rdevaul/yapPhoneBot/reference/Phonebot_BOM.xlsx

PhoneBot Bill of Materials
Item ID | Category | Subassembly | Part / Description | Qty | Unit | Material / Specification | Manufacturer / Supplier | Part Number | Unit Cost | Total Cost | Source / URL | Notes
3DP_1 | 3D Printed Part | Lower Body | PelvisTop | 1 | Each | PLA |  |  | $18.99 | $18.99 | PLA Basic | Bambu Lab US Store | The cost is based on one roll of PLA material from Bambu Lab
3DP_2 | 3D Printed Part | Lower Body | PelvisBottom | 1 | Each | PLA
3DP_3 | 3D Printed Part | Lower Body | HipBracket | 2 | Each | PLA
3DP_4 | 3D Printed Part | Lower Body | UpperLegLink | 2 | Each | PLA
3DP_5 | 3D Printed Part | Lower Body | LowerLegLink | 2 | Each | PLA
3DP_6 | 3D Printed Part | Lower Body | MotorConnection | 4 | Each | PLA
3DP_7 | 3D Printed Part | Lower Body | IdlerServoBracket | 2 | Each | PLA
3DP_8 | 3D Printed Part | Lower Body | Foot | 2 | Each | PLA
3DP_9 | 3D Printed Part | Torso | TorsoBase | 1 | Each | PLA
3DP_10 | 3D Printed Part | Torso | ElectronicsFrame | 1 | Each | PLA
3DP_11 | 3D Printed Part | Torso | PhoneMount | 1 | Each | PLA
F_1 | Standard Fastener |  | M2*5 Pan Head Screw | 92 | Each |  | Amazon | B0H5K71XJ3 | $0.12 | $11.02 | M2 x 5mm (50 Pack) Pan Head Machine Screw, Phillips Drive, Black Oxide 304 Stainless Steel, Fully Threaded,for Furniture Repairs and 3D Printer: Amazon.com: Industrial & Scientific (https://www.amazon.com/Machine-Phillips-Stainless-Threaded-Furniture/dp/B0H5K71XJ3) | Screws from motor boxes are enough for assembly
F_2 | Standard Fastener |  | M2.5*5 Thread Forming Screw | 32 | Each |  | Amazon | B0GY7QTS6R | $0.03 | $1.04 | IMSCREWS 400 Pcs M2.6 x 5mm Black Self Tapping Screws, 304 Stainless Steel Phillips Pan Washer Head, Natural Black No Peeling, Type A Point for Metal/Wood/Plastic: Amazon.com: Industrial & Scientific (https://www.amazon.com/IMSCREWS-Tapping-Stainless-Phillips-Natural/dp/B0GY7QTS6R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) | Screws from motor boxes are enough for assembly
F_3 | Standard Fastener |  | M2.5*12 Flat Head Screw | 60 | Each |  | Amazon | B0CG1QB1PD | $0.07 | $4.19 | M2.5-0.45 x 12mm Flat Head Socket Cap Screws, 10.9 Grade Alloy Steel,DIN 7991,Allen Socket Drive, Black Oxide Finish, Machine Thread, Countersunk Bolts,Fully Thread Quantity 100: Amazon.com: Industrial & Scientific (https://www.amazon.com/M2-5-0-45-Socket-Machine-Countersunk-Quantity/dp/B0CG1QB1PD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)
F_4 | Standard Fastener |  | M2.5*4 Round Head Screw | 6 | Each |  | Amazon | B0H5K1S5BR | $0.12 | $0.72 | M2.5 x 4mm(50 Pack) Button Head Hex Socket Cap Screws Bolts, Hex Drive Bright Finish Fully Machine Thread, Corrosion Resistant Black Oxide 304 Stainless Steel 18-8 Screws: Amazon.com: Industrial & Scientific (https://www.amazon.com/Button-Machine-Corrosion-Resistant-Stainless/dp/B0H5K1S5BR?s=industrial)
F_5 | Standard Fastener |  | M3*6 Round Head Screw | 9 | Each |  | Amazon | B0GJJGGS6R | $0.12 | $1.08 | M3 x 6mm(50 Pack) Button Head Hex Socket Cap Screws Bolts, Hex Drive Bright Finish Fully Machine Thread, Corrosion Resistant Black Oxide 304 Stainless Steel 18-8 Screws: Amazon.com: Industrial & Scientific (https://www.amazon.com/Button-Machine-Corrosion-Resistant-Stainless/dp/B0GJJGGS6R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)
F_6 | Standard Fastener |  | M3*10 Standoff | 4 | Each |  | Amazon | B07BLSRZYJ | $0.19 | $0.75 | PATIKIL 50 Pcs Male to Female Thread Spacer Screws M3 x 16mm + 6mm Brass Hex Standoff PCB Motherboard Spacer Screw Nut for Drone Quadcopter Computer Electronic Projects Circuit Board: Amazon.com: Industrial & Scientific (https://www.amazon.com/PATIKIL-Standoff-Motherboard-Quadcopter-Electronic/dp/B0FB2KP89V?s=industrial)
F_7 | Standard Fastener |  | M3*16 Standoff | 4 | Each |  | Amazon | B0FB2RPB24 | $0.25 | $0.99 | PATIKIL 50 Pcs Male to Female Thread Spacer Screws M3 x 16mm + 6mm Brass Hex Standoff PCB Motherboard Spacer Screw Nut for Drone Quadcopter Computer Electronic Projects Circuit Board: Amazon.com: Industrial & Scientific (https://www.amazon.com/PATIKIL-Standoff-Motherboard-Quadcopter-Electronic/dp/B0FB2RPB24?s=industrial)
F_8 | Standard Fastener |  | M2.5 Heat Insert | 6 | Each |  | McMaster | 94180A321 | $0.18 | $1.05 | Brass Tapered Heat-Set Threaded Inserts, for Plastic, M2.5 x 0.45mm Thread, 3.4mm Installed Length | McMaster-Carr (https://www.mcmaster.com/94180A321/)
F_9 | Standard Fastener |  | M3 Heat Insert | 9 | Each |  | McMaster | 94180A331 | $0.20 | $1.84 | Brass Tapered Heat-Set Threaded Inserts, for Plastic, M3 x 0.5mm Thread Size, 3.8mm Installed Length | McMaster-Carr (https://www.mcmaster.com/94180A331/)
F_10 | Standard Fastener |  | Thurst Needle Roller Bearing with Washers | 1 | Each |  | Amazon | B0GXNCS1ZD | $1.69 | $1.69 | uxcell 8 Sets AXK2542 Thrust Needle Roller Bearings with Washers, ID 25mm | OD 42mm, Thickness 4mm Chrome Steel, Needle Roller Bearings: Amazon.com: Industrial & Scientific (https://www.amazon.com/uxcell-AXK2542-Thrust-Bearings-Washers/dp/B0GXNCS1ZD?sp_csd=d2lkZ2V0TmFtZT1zcF9hdGY)
E_1 | Electronics |  | XL430-W250-T | 13 | Each |  | Robotis | 902-0135-000 | $23.90 | $310.70 | XL430-W250-T > XL Series | ROBOTIS (https://en.robotis.com/shop_en/item.php?it_id=902-0135-000)
E_2 | Electronics |  | U2D2 Power Hub | 1 | Each |  | Robotis | 902-0145-001 | $19.00 | $19.00 | U2D2 PHB Set > Interface | ROBOTIS (https://en.robotis.com/shop_en/item.php?it_id=902-0145-001)
E_3 | Electronics |  | U2D2 | 1 | Each |  | Robotis | 902-0132-000 | $32.10 | $32.10 | U2D2_INT > Interface | ROBOTIS (https://en.robotis.com/shop_en/item.php?it_id=902-0132-000)
E_4 | Electronics |  | Radxa ZERO 3W | 1 | Each |  | ARACE | RS107-D2E0H1W15 | $19.00 | $19.00 | Radxa Zero 3w Single Board Computer With Rk3566 4-core Cpu Gpu Npu 1080p Output Wifi 6 Bt 5.4 Enhanced Connectivity - Buy Product on Alibaba.com (https://www.alibaba.com/product-detail/Radxa-ZERO-3W-Single-Board-Computer_1601435694506.html)
E_5 | Electronics |  | LM2596 DC Converter | 1 | Each |  | Amazon | B0DBVYP91F | $1.60 | $1.60 | Amazon.com: Seloky 5 Pack LM2596 DC to DC Buck Converter 3.0-40V to 1.5-35V Adjustable Voltage Regulator Electronic Voltage Stabilizer Power Supply Step Down Module : Electronics (https://www.amazon.com/Seloky-Converter-Adjustable-Electronic-Stabilizer/dp/B0DBVYP91F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)
E_6 | Electronics |  | 3S Lipo Battery 2200mAh | 1 | Each |  | Amazon | B0BYNSH6Q7 | $17.06 | $17.06 | Amazon.com: Zeee 3S Lipo Battery 2200mAh 11.1V 50C Shorty Pack Battery with XT60 Plug for RC Car Truck RC Vehicles Boat Drone RC Airplane Quadcopter Helicopter FPV Racing Hobby Models(2 Pack) : Toys & Games (https://www.amazon.com/Zeee-Vehicles-Airplane-Quadcopter-Helicopter/dp/B0BYNSH6Q7)
