rdevaul/yapPhoneBot/reference/PhoneBot_Asm.step

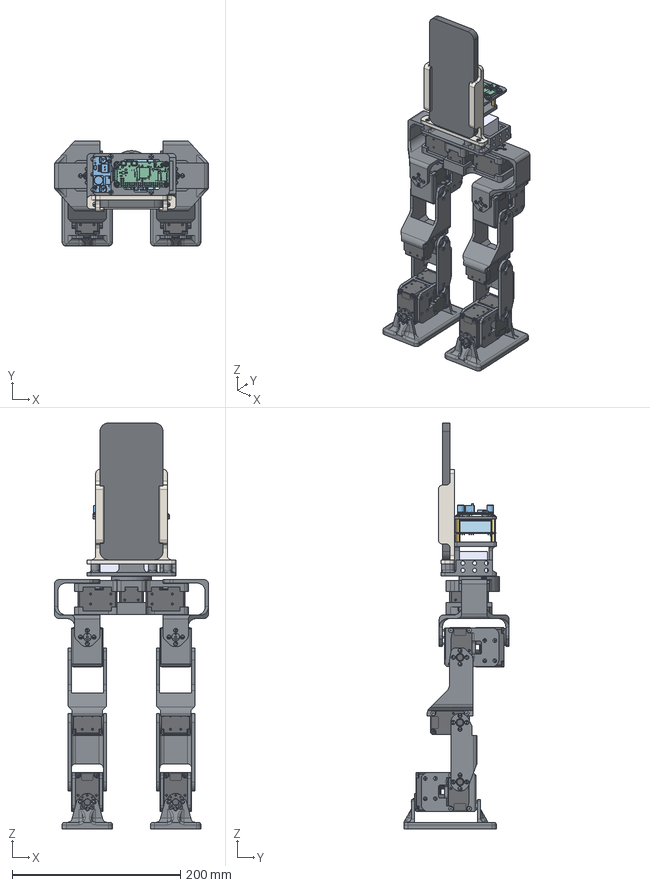
[picture p1: CAD file, 2026-10-24]
reference/PhoneBot_Asm.step
183.0 x 125.2 x 482.4 mm
92000A012 M2x5 PanHead x 92
M2.5x12-FlatHead x 60
M2x6-SocketHead x 4
Foot x 2
5909K76-Washer x 2
LowerLegLink x 2
PelvisTop
UpperLegLink x 2
HipBracket x 2
PelvisBottom
98952A108-M3x10-HexStandoff x 4
94180A331-M3-HeatInsert x 9
PhoneMount
Part2_ADA3708__NONE x 80
ram__NONE x 171
545482271__NONE x 26
690 - 019 - 298 - 903__NONE x 21
690 - 005 - 298 - 486__NONE_1 x 69
690 - 005 - 298 - 486__NONE x 69
pcb__NONE x 49
1040310811__NONE x 9
BCM 2835__NONE x 2
ROBOTIS_U2D2-1/U2D2.ASM-1/PCB_U2D2.PRT-1-solid1
ROBOTIS_U2D2_Power_Hub_Board-1/JST-B4B-EH-A.PRT.1-3-solid1
ROBOTIS_U2D2-1/U2D2.ASM-1/MICRO_USB_2_0_CONNECTOR__AB_REC.PRT-1-solid 1
ROBOTIS_U2D2_Power_Hub_Board-1/JST-B3B-EH-A.PRT.1-2-solid1
ROBOTIS_U2D2-1/U2D2.ASM-1/JST-B4B-PH-K-S.PRT-1-solid1
ROBOTIS_U2D2-1/U2D2.ASM-1/U2D2_CASING.PRT-1-solid1
ROBOTIS_U2D2_Power_Hub_Board-1/JST-B3B-EH-A.PRT.1-1-solid1
ROBOTIS_U2D2-1/U2D2.ASM-1/JST-B4B-EH-A.PRT-1-solid1
ROBOTIS_U2D2_Power_Hub_Board-1/JST-B4B-EH-A.PRT.1-2-solid1
ROBOTIS_U2D2-1/U2D2.ASM-1/JST-B3B-EH-A.PRT-1-solid1
ROBOTIS_U2D2_Power_Hub_Board-1/JST-B4B-EH-A.PRT.1-1-solid1
ROBOTIS_U2D2_Power_Hub_Board-1/JST-B3B-EH-A.PRT.1-3-solid1
ROBOTIS_U2D2_Power_Hub_Board-1/39281023.stp-1/39281023.prt-1-solid1
ROBOTIS_U2D2_Power_Hub_Board-1/Board-1-solid1
92095A456-M2.5x4-ButtonHead x 6
M2.5-HeatInsert x 6
M3x6-ButtonHead x 9
98952A114-M3x16-HexStandoff x 4
Phone
User Library-DC-DC MODULE LM2596s_User Library-TO-263-5_TO-263-5_Body _1__NONE
User Library-DC-DC MODULE LM2596s_User Library-TO-263-5_TO-263-5_Lead s_1__NONE
User Library-DC-DC MODULE LM2596s_User Library-TO-263-5_TO-263-5_Mark ing_1__NONE x 8
PCB_LM2596 corrected 061823__NONE
DIODE_LM2596__NONE
User Library-DC-DC MODULE LM2596s_C0603__NONE_1
POT_LM2596__NONE
User Library-DC-DC MODULE LM2596s_C0603__NONE
User Library-DC-DC MODULE LM2596s_User Library-ALU-F_Pins_1__NONE_1
User Library-DC-DC MODULE LM2596s_R0603__NONE
INDUCTOR_LM2596__NONE
User Library-DC-DC MODULE LM2596s_User Library-ALU-F_Fuss_1__NONE_1
User Library-DC-DC MODULE LM2596s_User Library-ALU-F_Fuss_1__NONE
User Library-DC-DC MODULE LM2596s_User Library-ALU-F_K_X_F6rper_1__NO NE_1
User Library-DC-DC MODULE LM2596s_User Library-ALU-F_K_X_F6rper_1__NO NE
User Library-DC-DC MODULE LM2596s_User Library-ALU-F_Beschriftung_1__ NONE_1
User Library-DC-DC MODULE LM2596s_User Library-ALU-F_Beschriftung_1__ NONE
User Library-DC-DC MODULE LM2596s_User Library-ALU-F_Pins_1__NONE
ElectronicsFrame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
