rdevaul/yapPhoneBot/reference/stl/thigh_link.stl

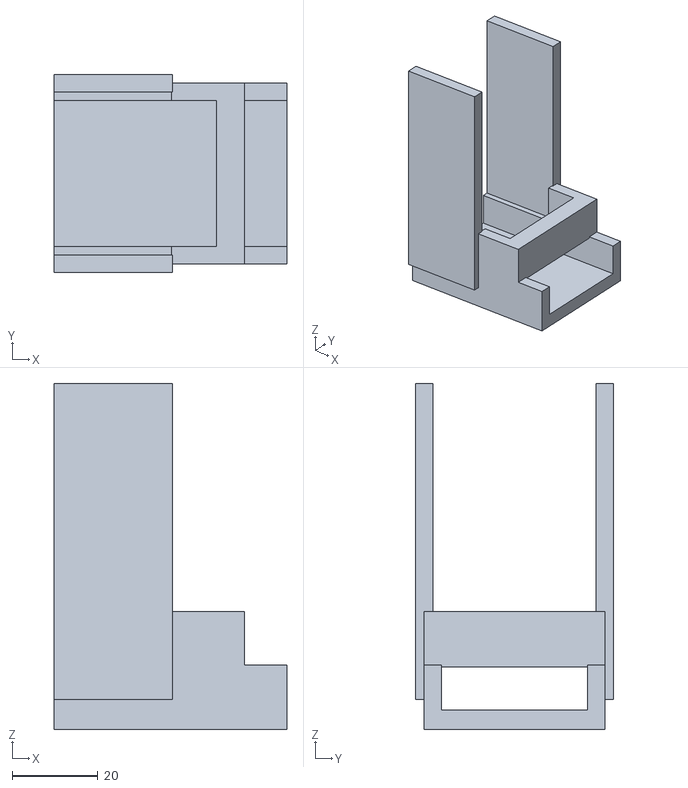
[picture p2: CAD file, 2026-10-24]
reference/stl/thigh_link.stl
54.2 x 46.0 x 80.5
