rdevaul/yapPhoneBot/reference/stl/IdlerServoBracket.stl

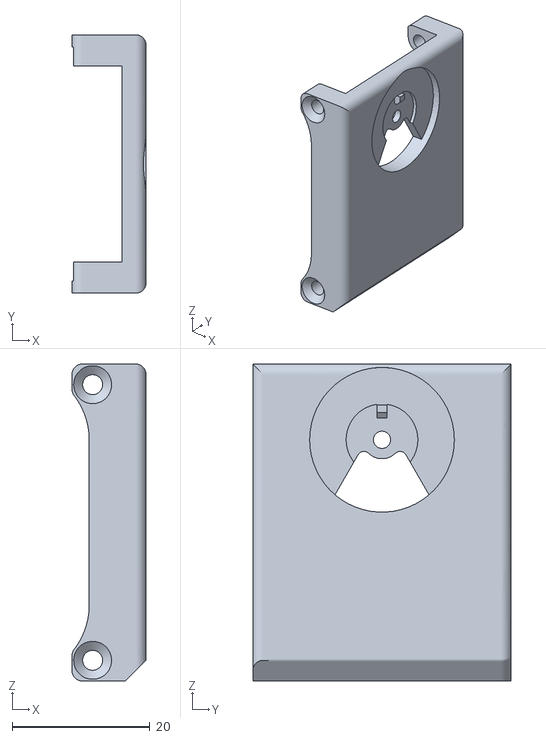
[picture p3: CAD file, 2026-10-24]
reference/stl/IdlerServoBracket.stl
10.7 x 37.5 x 46.0
