rdevaul/yapPhoneBot/reference/stl/ElectronicsFrame.stl

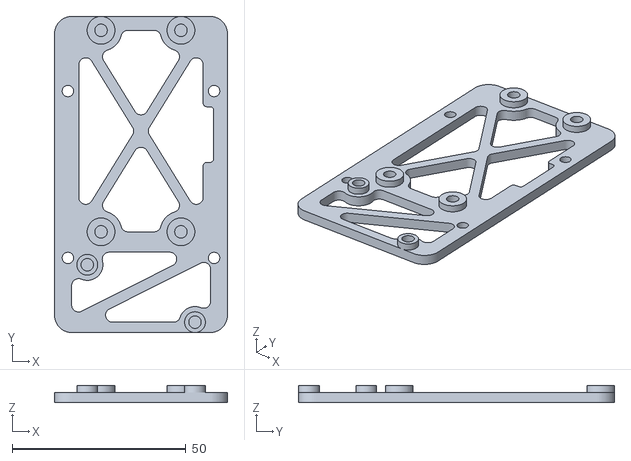
[picture p4: CAD file, 2026-10-24]
reference/stl/ElectronicsFrame.stl
49.8 x 91.0 x 5.00
