rdevaul/yapPhoneBot/reference/stl/foot_plate.stl

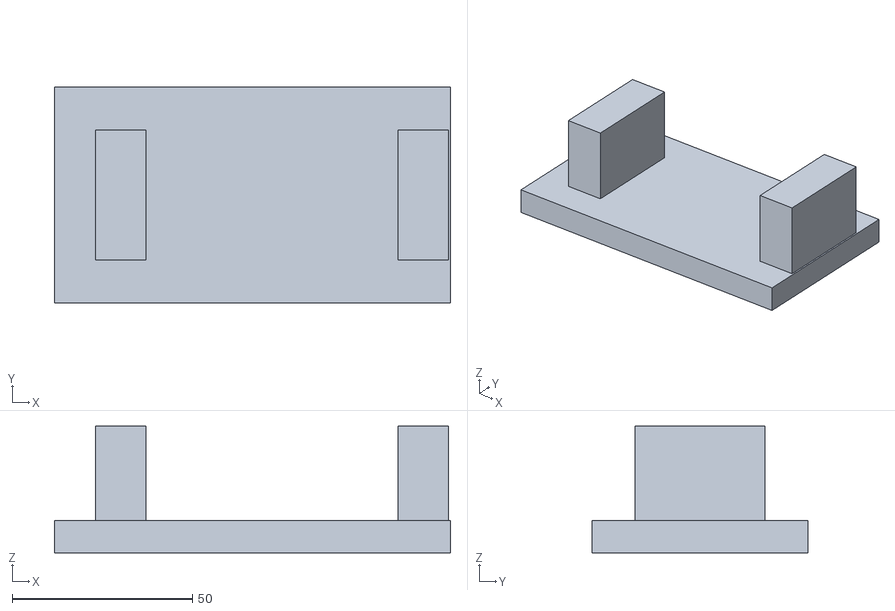
[picture p5: CAD file, 2026-10-24]
reference/stl/foot_plate.stl
110.0 x 60.0 x 35.2
