rdevaul/yapPhoneBot/reference/stl/shin_link.stl

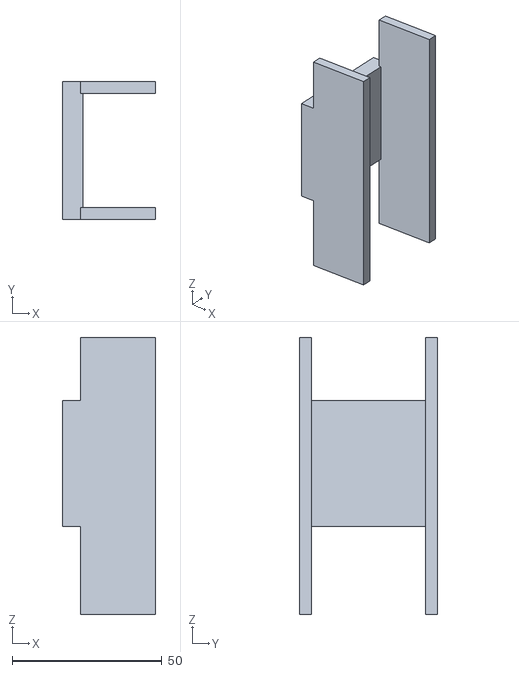
[picture p6: CAD file, 2026-10-24]
reference/stl/shin_link.stl
31.0 x 46.0 x 92.4
