rdevaul/yapPhoneBot/reference/stl/LowerLegLink.stl

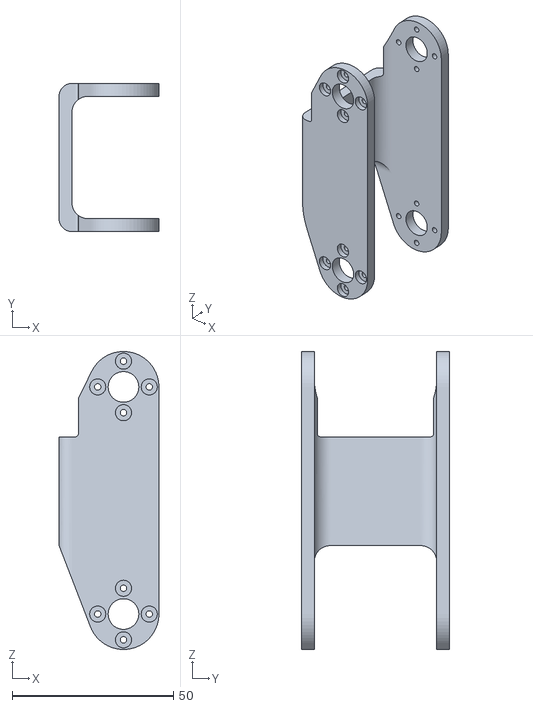
[picture p7: CAD file, 2026-10-24]
reference/stl/LowerLegLink.stl
31.0 x 46.0 x 92.5
