rdevaul/yapPhoneBot/reference/stl/MotorConnection.stl

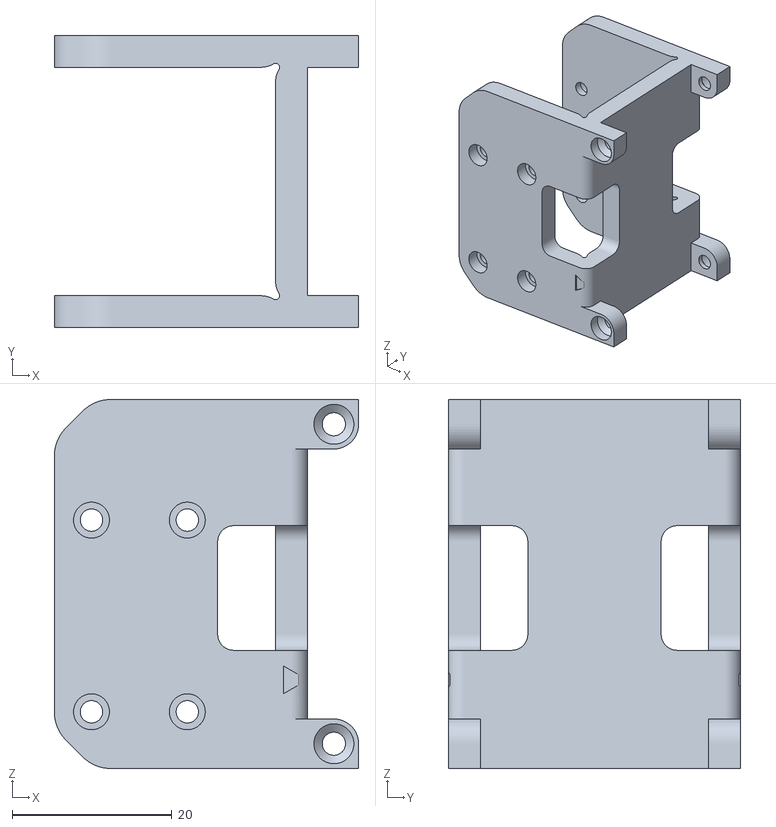
[picture p8: CAD file, 2026-10-24]
reference/stl/MotorConnection.stl
38.1 x 36.6 x 46.2
