rdevaul/yapPhoneBot/reference/stl/UpperLegLink.stl

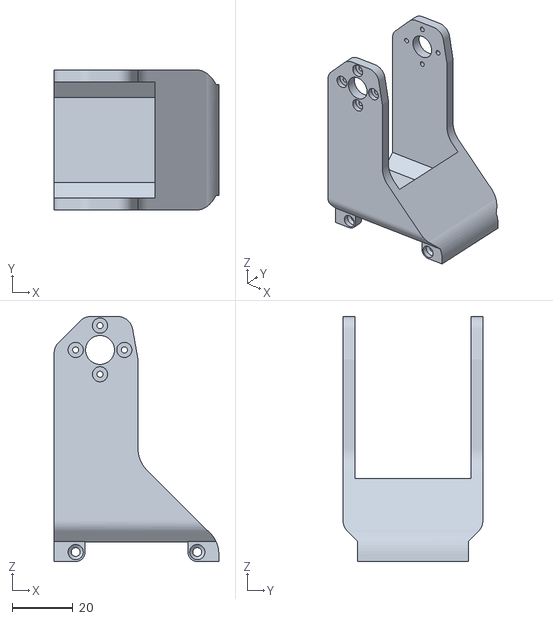
[picture p9: CAD file, 2026-10-24]
reference/stl/UpperLegLink.stl
54.2 x 46.0 x 80.6
