rdevaul/yapPhoneBot/reference/stl/PelvisBottom.stl

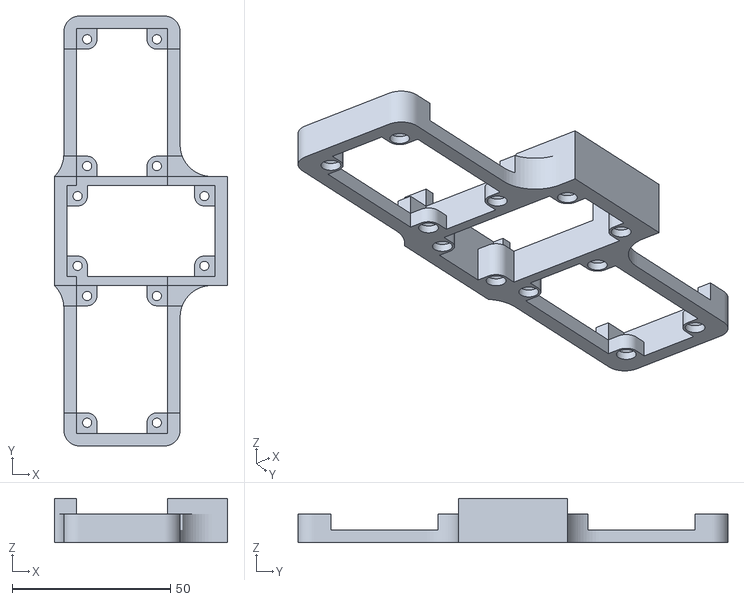
[picture p10: CAD file, 2026-10-24]
reference/stl/PelvisBottom.stl
54.7 x 135.7 x 14.0
