rdevaul/yapPhoneBot/reference/stl/Foot.stl

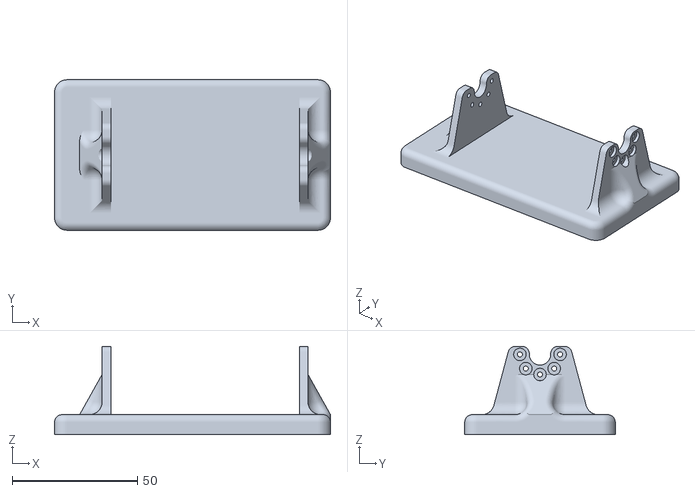
[picture p11: CAD file, 2026-10-24]
reference/stl/Foot.stl
110.0 x 60.0 x 35.2
