rdevaul/yapPhoneBot/reference/stl/PelvisTop.stl

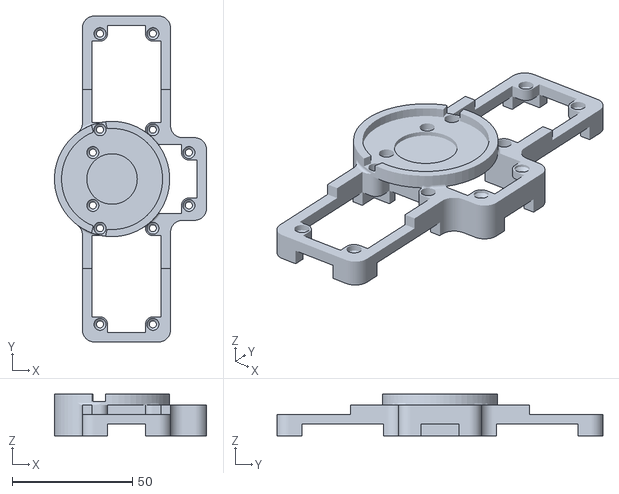
[picture p12: CAD file, 2026-10-24]
reference/stl/PelvisTop.stl
63.3 x 135.7 x 17.4
