rdevaul/yapPhoneBot/reference/stl/HipBracket.stl

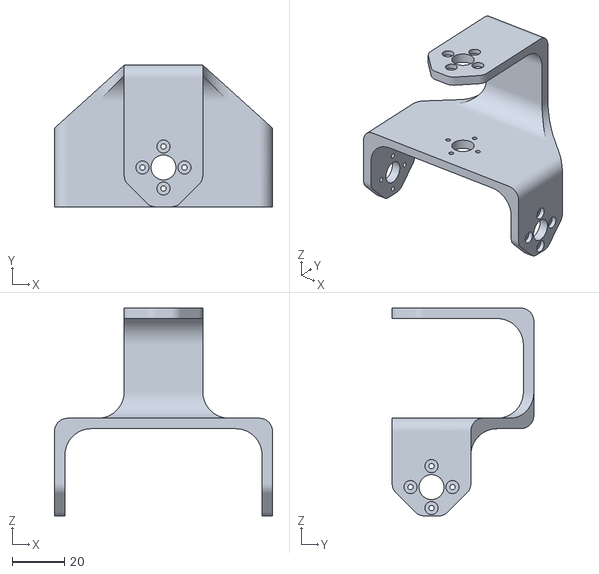
[picture p13: CAD file, 2026-10-24]
reference/stl/HipBracket.stl
83.1 x 54.0 x 79.3
