rdevaul/yapPhoneBot/reference/stl/TorsoBase.stl

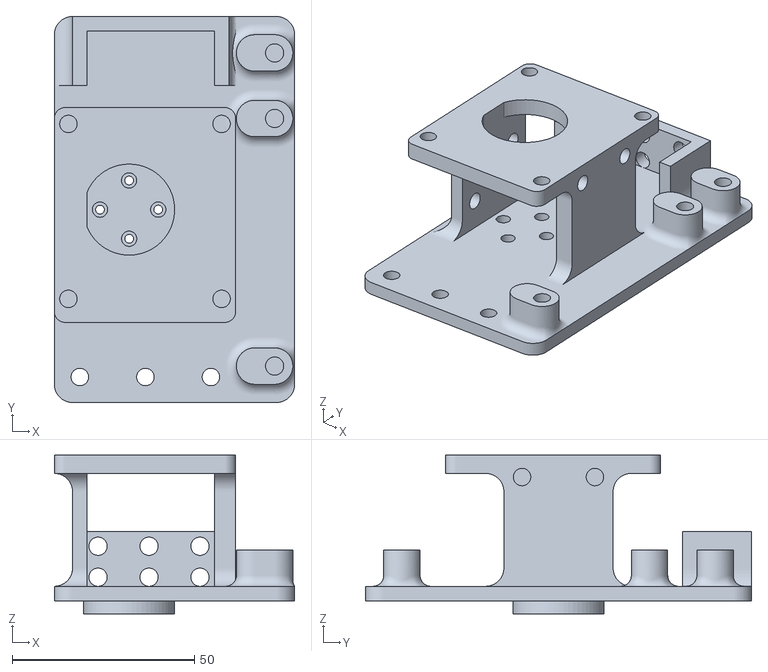
[picture p14: CAD file, 2026-10-24]
reference/stl/TorsoBase.stl
66.0 x 106.0 x 43.5
