rdevaul/yapPhoneBot/reference/stl/Phone.stl

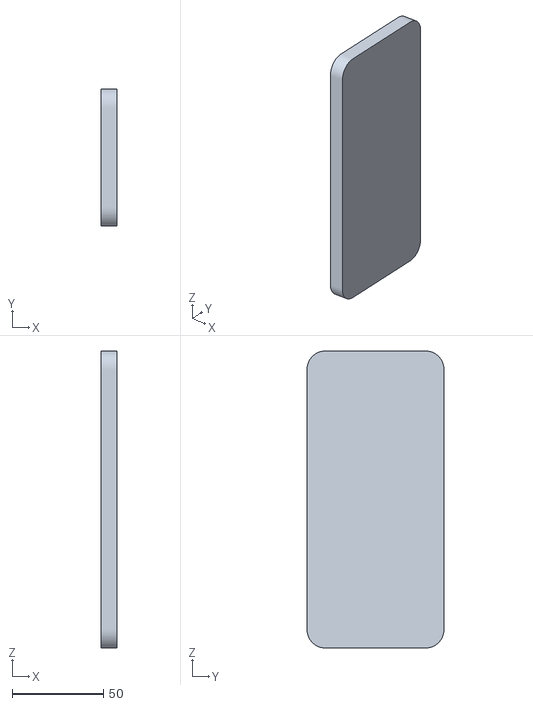
[picture p15: CAD file, 2026-10-24]
reference/stl/Phone.stl
9.00 x 74.9 x 162.6
