rdevaul/yapPhoneBot/reference/stl/PhoneMount.stl

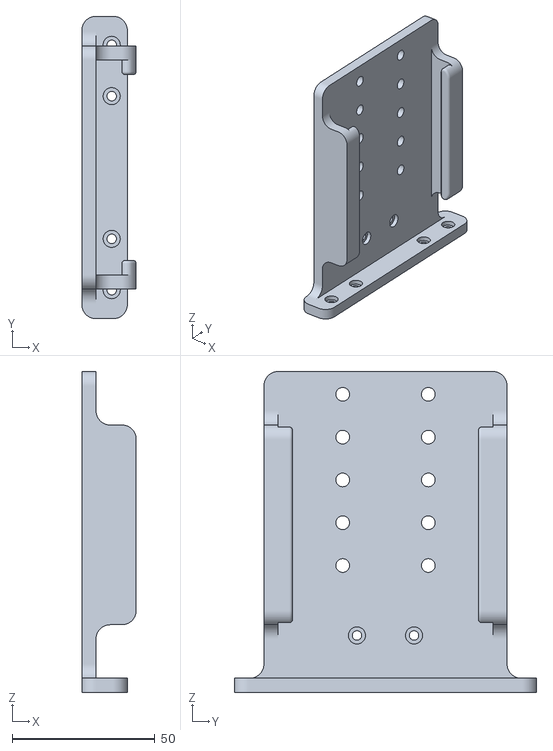
[picture p16: CAD file, 2026-10-24]
reference/stl/PhoneMount.stl
19.1 x 106.0 x 112.5
