rdevaul/yapPhoneBot/(list of files, cad)

Other CAD files:
reference/stl/local_LowerLegLink.stl
reference/stl/local_UpperLegLink.stl
reference/stl/local_Foot.stl
