rdevaul/yapPhoneBot/(commit log)

2026-10-24 Initial commit: yapPhoneBot v0.1.0 scaffolding
    - designs/: yaphonebot_servo.dsl, yaphonebot_leg.dsl, yaphonebot_torso.dsl, yaphonebot_assembly.dsl
    - src/yaphonebot/kinematics/: forward kinematics chain (DH parameters)
    - tests/: geometry comparison tests + kinematics validation
    - bom/: procurement catalog v0.1
    - tools/build_ycpkg.py: package builder (stub)
    - MIT licensed, inspired by phonebot.dev (CC BY-NC 4.0)
2026-10-24 Switch to SDF-first build (yapCAD 1.2.0+)
    - Updated yapCAD pin to latest main (e530149) with SDF geometry system
    - environment.yml: OCC now optional, SDF works with numpy-only conda env
    - build_ycpkg.py: uses representation='sdf' with per-part fallback
    - README: notes that OCC is optional for development
2026-10-24 DSL files working — STL generation proven
    - Fixed all 4 .dsl files to match yapCAD v2 DSL syntax:
    - No 'let' keyword (deprecated) — use 'name: type = value'
    - No 'param' keyword — use command-based constants
    - No module-level vars — all declarations inside commands
    - 'shell' is a reserved type keyword, renamed to 'hull'
    - assembly builtins: assembly() / add_part() / compound()
    - Generated STL outputs from yapCAD run:
    - xl430_envelope.stl (46k vol, 85KB STL)
    - left_leg.stl (389k vol, 181KB STL)
    - torso.stl (451k vol, 117KB STL)
    - phonebot_full.stl (1.23M vol, 478KB STL — full robot)
    - Remaining: individual leg/torso/servo .dsl files are subs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
2026-10-24 Re-architect to multi-file DSL modules with 'use' imports
    DSL files now use proper cross-file imports:
    - yaphonebot_servo.dsl: XL430-W250-T envelope (base primitive)
    - yaphonebot_leg.dsl: 6-DoF leg chain (use yaphonebot_servo)
    - yaphonebot_torso.dsl: torso yaw joint + accessories (use yaphonebot_servo)
    - yaphonebot_assembly.dsl: full robot (use yaphonebot_leg, use yaphonebot_torso)
    The yapCAD DSL 'use' statement was previously unimplemented (parsed
    but never resolved). The fix is in PR#100 on rdevaul/yapCAD
    (fix/dsl-use-imports branch). This repo works with the patched version.
2026-10-24 Align geometry with reference CAD: fix servo envelope, part shapes, coordinate frame, and joint centers
    - **servo.dsl**: Reorient body axis (X=46.5, Y=28.5, Z=34.0) and shaft
    diameter/offset to match GrabCAD / Robotis datasheet
    - **torso.dsl**: Complete rewrite — PelvisTop/Bottom, TorsoBase, vertical
    PhoneMount+Phone, ElectronicsFrame (SBC/U2D2/LM2596), battery (Zeee 3S
    Shorty), and HipBracket C-brackets, all dimensioned from STEP export
    - **leg.dsl**: Complete rewrite — thigh (UpperLegLink C-channel + knee
    bracket + gusset), shin (LowerLegLink C-channel + rear web), foot (sole +
    front/rear ankle arches), hip/ankle dual-servo brackets (MotorConnection +
    IdlerServoBracket). Jo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
    [ElectronicsFrame.stl, Foot.stl, HipBracket.stl, IdlerServoBracket.stl, LowerLegLink.stl, MotorConnection.stl, PelvisBottom.stl, PelvisTop.stl]
2026-10-24 Add ROM sweep demo script and pin yapCAD to 12bbe93 (rom package)
    - tools/sweep_leg_rom.py: Demonstrates yapcad.rom on phonebot leg kinematic
    chain with 9 links, 8 adjacent pairs, SDF clearance without meshing
    - Pin environment.yml and pyproject.toml to yapCAD commit 12bbe93
2026-10-26 updated gitignore to ignore reference CAD data
